Engr-Samson-Beloved/Goal-Line-Tech/GoalPost_Design_and_Code.docx

SMART GOAL-LINE DETECTION SYSTEM

Goal Post Unit — Design & Arduino Code

Chapter 3 Technical Reference | Hardware · Wiring · Firmware

# 1. Goal Post Unit — Design Overview

Each goal post unit is a completely self-contained system. It generates its own power from solar, detects ball crossings using two independent sensor rows, verifies the direction of crossing, and wirelessly notifies the referee. No cables connect it to any other unit.

## 1.1 System Block Diagram

┌─────────────────────────────────────────────────────────────────────┐

│ GOAL POST UNIT │

│ │

│ [SOLAR PANEL 50W] │

│ │ 12V DC │

│ ▼ │

│ [CHARGE CONTROLLER] ────────► [12V 12Ah BATTERY] │

│ │ │

│ ┌─────────────────────────────┤ │

│ │ 12V │ via BUCK │ via BUCK │

│ ▼ ▼ (5V) ▼ (3.3V) │

│ [8x E3F-10DN BEAM] [ESP32-CAM] [ESP32 CONTROLLER] │

│ Transmitters + ▲ │ │

│ Receivers │ UART │ GPIO reads │

│ └──────────┤ │

│ [8x TCRT5000] ──── GPIO ───────────────►│ │

│ (secondary row) │ │

│ │ SPI │

│ [MICROSD MODULE] ◄──────────────────────┤ │

│ │ ESP-NOW (wireless) │

└───────────────────────────────────────────┼─────────────────────────┘

│

▼

[REFEREE WRIST UNIT]

## 1.2 Complete Component List — Goal Post Unit

# | Component | Exact Name to Order | Qty | Role

1 | E3F-10DN Beam Sensor | E3F-10DN Infrared Through-Beam Photoelectric Sensor 10M NPN Opposite Type | 16 (8 pairs) | Primary detection — invisible curtain across goal line
2 | TCRT5000 | TCRT5000 Infrared Reflective Line Track Sensor Module | 8 | Secondary row — direction confirmation
3 | ESP32 Controller | ESP32 DevKit V1 30-pin | 1 | Main brain — all detection logic and wireless
4 | ESP32-CAM | ESP32-CAM AI-Thinker Module | 1 | Visual capture of every goal event
5 | OV2640 Fisheye Lens | OV2640 160 degree fisheye camera module | 1 | Widens camera view across goal area
6 | MicroSD Module | SPI MicroSD Card Adapter Module | 1 | Logs every event with timestamp
7 | Solar Panel | 50W 12V Monocrystalline Solar Panel | 1 | Primary power generation
8 | Charge Controller | PWM Solar Charge Controller 10A 12V | 1 | Manages battery charging safely
9 | Lead Acid Battery | 12V 12Ah Sealed Lead Acid Battery | 1 | Stores power for night and cloudy matches
10 | Buck Converter | LM2596 DC-DC Step Down Module | 2 | 12V→5V for camera, 12V→3.3V for controller
11 | IP65 Enclosure | IP65 Waterproof Junction Box Small | 3 | Weatherproofs electronics at each mount point
12 | 2N2222 Transistor | 2N2222 NPN Transistor | 4 | Protects GPIO pins from direct high current
13 | 1N4007 Diode | 1N4007 Rectifier Diode | 4 | Flyback protection for inductive loads
14 | Resistors | 330Ω resistor | 8 | Current limiting for sensor signal lines
15 | MicroSD Card | MicroSD Card 8GB or 16GB Class 10 | 1 | Storage medium for the SD module
16 | Jumper Wires | Male-to-female jumper wires 30cm | 2 packs | Component connections on breadboard/perfboard
17 | Perfboard | Universal PCB Prototype Board 10x15cm | 1 | Permanent mounting of controller connections

Buy all quantities twice — one complete set per goal post.

# 2. Sensor Design

## 2.1 Primary Sensor — E3F-10DN Through-Beam Array

The E3F-10DN is a through-beam sensor. The transmitter sits on one goal post and the receiver sits directly opposite on the other post. The transmitter fires a continuous invisible infrared beam at the receiver. When the ball passes through and blocks the beam, the receiver outputs a LOW signal to the ESP32.

## 2.2 Vertical Beam Placement

Eight beams are stacked vertically from ground level to the top of the goal. A standard football is 22cm in diameter. Beams are spaced 30cm apart. At that spacing it is physically impossible for the ball to pass between two beams.

LEFT POLE RIGHT POLE

│ │

[T8]═══════════════════ BEAM 8 ══════════════════════► [R8] 210cm — top corners

[T7]═══════════════════ BEAM 7 ══════════════════════► [R7] 180cm

[T6]═══════════════════ BEAM 6 ══════════════════════► [R6] 150cm

[T5]═══════════════════ BEAM 5 ══════════════════════► [R5] 120cm — chest height

[T4]═══════════════════ BEAM 4 ══════════════════════► [R4] 90cm

[T3]═══════════════════ BEAM 3 ══════════════════════► [R3] 60cm

[T2]═══════════════════ BEAM 2 ══════════════════════► [R2] 35cm — low drives

[T1]═══════════════════ BEAM 1 ══════════════════════► [R1] 10cm — ground rollers

│ │

══════════════════════ GOAL LINE (7.32m) ═══════════════════════

Transmitters [T1–T8] mount on the LEFT pole. Receivers [R1–R8] mount on the RIGHT pole. Both sets are fixed inside small IP65 enclosures with a clear lens window facing outward.

## 2.3 Secondary Sensor — TCRT5000 Direction Row

Eight TCRT5000 reflective sensors are mounted on a fabricated steel rod running the full 7.32m width of the goal, positioned 8cm inside the goal from the beam curtain, facing downward at the ground. When the ball passes over a sensor, its reflection is interrupted and the sensor outputs a LOW signal.

TOP VIEW — looking down from above:

PITCH SIDE

══ T1══ T2══ T3══ T4══ T5══ T6══ T7══ T8══ ← BEAM CURTAIN (goal line)

● ● ● ● ● ● ● ● ← TCRT5000 row (8cm inside)

S1 S2 S3 S4 S5 S6 S7 S8

GOAL NET SIDE

← 7.32m total width →

TCRT5000 sensors spaced every 91cm on welded rod facing downward

# 3. Full Wiring — Pin by Pin

## 3.1 E3F-10DN Beam Receivers → ESP32 Controller

Each receiver has 3 wires: Brown (+12V), Blue (GND), Black (signal output NPN). The signal wire connects to the ESP32 GPIO through a 330Ω resistor. When beam is clear the output is HIGH. When beam is broken the output is LOW.

Receiver | Wire Colour | Connects To | ESP32 GPIO
R1 (10cm) | Brown | 12V power rail | —
R1 (10cm) | Blue | GND | —
R1 (10cm) | Black (signal) | 330Ω → GPIO 13 | GPIO 13
R2 (35cm) | Black (signal) | 330Ω → GPIO 12 | GPIO 12
R3 (60cm) | Black (signal) | 330Ω → GPIO 14 | GPIO 14
R4 (90cm) | Black (signal) | 330Ω → GPIO 27 | GPIO 27
R5 (120cm) | Black (signal) | 330Ω → GPIO 26 | GPIO 26
R6 (150cm) | Black (signal) | 330Ω → GPIO 25 | GPIO 25
R7 (180cm) | Black (signal) | 330Ω → GPIO 33 | GPIO 33
R8 (210cm) | Black (signal) | 330Ω → GPIO 32 | GPIO 32

All 8 receivers share the same 12V and GND rails. Only the signal wire differs per receiver. All transmitters also share 12V and GND — they have no signal wire, just power.

## 3.2 TCRT5000 Sensors → ESP32 Controller

Each TCRT5000 has 4 pins: VCC, GND, D0 (digital), A0 (analog). Only VCC, GND, and D0 are used. D0 goes LOW when ball is detected above the sensor.

Sensor | VCC | GND | D0 → GPIO
S1 | 3.3V | GND | GPIO 23
S2 | 3.3V | GND | GPIO 22
S3 | 3.3V | GND | GPIO 21
S4 | 3.3V | GND | GPIO 19
S5 | 3.3V | GND | GPIO 18
S6 | 3.3V | GND | GPIO 5
S7 | 3.3V | GND | GPIO 17
S8 | 3.3V | GND | GPIO 16

## 3.3 ESP32-CAM → ESP32 Controller

The ESP32-CAM communicates via UART serial. It has its own ESP32 chip onboard. Use UART2 on the controller to leave UART0 free for USB debugging.

ESP32-CAM Pin | Controller Pin | Wire
TX (GPIO 1) | RX2 (GPIO 16 on controller — use a spare UART) | Yellow
RX (GPIO 3) | TX2 (GPIO 17 on controller) | Orange
GND | GND | Black
5V | 5V from buck converter output | Red
GPIO 0 | GND during flashing only — remove after | —

## 3.4 MicroSD Module → ESP32 Controller (SPI)

SD Module Pin | ESP32 GPIO | Notes
VCC | 3.3V | Power
GND | GND | Ground
CS | GPIO 4 | Chip Select
MOSI | GPIO 23 | Data to SD — share with SPI bus
CLK | GPIO 18 | Clock — share with SPI bus
MISO | GPIO 19 | Data from SD — share with SPI bus

Note: GPIO 23, 18, 19 are shared SPI pins. The SD module CS on GPIO 4 enables/disables it independently. If SPI conflicts arise, use a dedicated CS pin.

## 3.5 Power Wiring — Complete Rail Map

SOLAR PANEL (+) ─────► CHARGE CONTROLLER (Solar +)

SOLAR PANEL (−) ─────► CHARGE CONTROLLER (Solar −)

CHARGE CONTROLLER (Battery +) ──► BATTERY (+)

CHARGE CONTROLLER (Battery −) ──► BATTERY (−)

BATTERY (+) ──► FUSE (5A) ──► 12V RAIL

BATTERY (−) ──────────────────► GND RAIL

12V RAIL ──► E3F Transmitters (Brown wire)

12V RAIL ──► E3F Receivers (Brown wire)

GND RAIL ──► E3F Transmitters (Blue wire)

GND RAIL ──► E3F Receivers (Blue wire)

12V RAIL ──► BUCK CONVERTER 1 (IN+) ──► OUT+ = 5V

GND RAIL ──► BUCK CONVERTER 1 (IN−) ──► OUT− = GND

5V ──► ESP32-CAM (5V pin)

12V RAIL ──► BUCK CONVERTER 2 (IN+) ──► OUT+ = 3.3V

GND RAIL ──► BUCK CONVERTER 2 (IN−) ──► OUT− = GND

3.3V ──► ESP32 Controller (3.3V or VIN pin)

3.3V ──► All 8 TCRT5000 (VCC)

3.3V ──► MicroSD Module (VCC)

⚠ Critical Warning

Never connect 12V directly to any ESP32 pin. The ESP32 operates at 3.3V logic. Connecting 12V will permanently destroy the chip. The buck converters are not optional.

# 4. Detection Logic Flow

The ESP32 controller runs a continuous loop checking every sensor. The decision sequence is strict — both conditions must be met in the right order within the right time window.

┌─────────────────────────────────────────────────────────────────┐

│ ESP32 MAIN LOOP │

└─────────────────────────────────────────────────────────────────┘

│

▼

Any PRIMARY beam broken (LOW)?

│ │

YES NO ──► keep polling

│

▼

Start 50ms countdown timer

│

▼

Any SECONDARY TCRT5000 triggered within 50ms?

│ │

YES NO ──► REJECTED

│ log: NO_DIRECTION

▼

GOAL CONFIRMED

│

▼

Ask ESP32-CAM to capture frame (via UART)

│

▼

Send ESP-NOW wireless signal (Post ID + goal flag)

│

▼

Wait for ACK from wrist unit (200ms timeout)

│ │

ACK No ACK ──► retry up to 3 times

│

▼

Write event to SD card (timestamp + sensors + result)

│

▼

3 second cooldown ──► resume polling

# 5. Arduino Code — ESP32 Controller (Goal Post Brain)

This is the complete firmware for the ESP32 DevKit V1 that acts as the brain of each goal post unit. Flash using Arduino IDE. The only change between Goal Post A and Goal Post B is the POST_ID variable on line 1.

## 5.1 Required Libraries

Install these in Arduino IDE via Tools → Manage Libraries:

- ESP-NOW — built into ESP32 Arduino core, no install needed
- WiFi — built into ESP32 Arduino core, no install needed
- SD — built into Arduino, no install needed
- SPI — built into Arduino, no install needed

## 5.2 Full Goal Post Controller Code

// ═══════════════════════════════════════════════════════════════════

// SMART GOAL-LINE DETECTION SYSTEM

// Goal Post Controller Firmware — ESP32 DevKit V1

// Change POST_ID below: "A" for Goal Post A, "B" for Goal Post B

// ═══════════════════════════════════════════════════════════════════

#include <esp_now.h>

#include <WiFi.h>

#include <SD.h>

#include <SPI.h>

// ── CONFIGURATION ───────────────────────────────────────────────────

const String POST_ID = "A"; // "A" or "B"

// Wrist unit MAC address — replace with your ESP32-C3 MAC address

// Find it by uploading a blank sketch and reading Serial Monitor

uint8_t WRIST_MAC[] = {0xFF, 0xFF, 0xFF, 0xFF, 0xFF, 0xFF};

// ── PRIMARY BEAM RECEIVER PINS (E3F-10DN signal wires) ──────────────

const int PRIMARY[8] = {13, 12, 14, 27, 26, 25, 33, 32};

// R1 R2 R3 R4 R5 R6 R7 R8

// 10cm 35cm 60cm 90cm 120cm 150cm 180cm 210cm

// ── SECONDARY TCRT5000 PINS ─────────────────────────────────────────

const int SECONDARY[8] = {23, 22, 21, 19, 18, 5, 17, 16};

// S1 S2 S3 S4 S5 S6 S7 S8

// ── SD CARD ─────────────────────────────────────────────────────────

const int SD_CS = 4;

// ── STATE VARIABLES ─────────────────────────────────────────────────

bool primaryTriggered = false;

bool ackReceived = false;

unsigned long primaryTime = 0;

const unsigned long DIRECTION_WINDOW = 50; // milliseconds

const unsigned long ACK_TIMEOUT = 200; // milliseconds

const int MAX_RETRIES = 3;

const unsigned long COOLDOWN = 3000; // milliseconds

// ── MESSAGE STRUCTURE ────────────────────────────────────────────────

typedef struct {

char postID[2];

bool isGoal;

unsigned long timestamp;

} GoalMessage;

// ═══════════════════════════════════════════════════════════════════

// LOGGING

// ═══════════════════════════════════════════════════════════════════

void logEvent(String result, int beamTriggered, int tcrtTriggered) {

if (!SD.begin(SD_CS)) return;

File f = SD.open("/goallog.txt", FILE_APPEND);

if (f) {

f.print("TIME:");

f.print(millis());

f.print(" POST:");

f.print(POST_ID);

f.print(" BEAM:");

f.print(beamTriggered);

f.print(" TCRT:");

f.print(tcrtTriggered);

f.print(" RESULT:");

f.println(result);

f.close();

}

}

// ═══════════════════════════════════════════════════════════════════

// ESP-NOW — ACK RECEIVED FROM WRIST UNIT

// ═══════════════════════════════════════════════════════════════════

void onDataRecv(const uint8_t *mac, const uint8_t *data, int len) {

ackReceived = true;

Serial.println("ACK received from wrist unit.");

}

// ═══════════════════════════════════════════════════════════════════

// SEND GOAL SIGNAL TO WRIST UNIT (with retry)

// ═══════════════════════════════════════════════════════════════════

void sendGoalSignal(int beamNum, int tcrtNum) {

GoalMessage msg;

POST_ID.toCharArray(msg.postID, 2);

msg.isGoal = true;

msg.timestamp = millis();

ackReceived = false;

for (int attempt = 1; attempt <= MAX_RETRIES; attempt++) {

Serial.print("Sending goal signal — attempt ");

Serial.println(attempt);

esp_now_send(WRIST_MAC, (uint8_t*)&msg, sizeof(msg));

unsigned long sent = millis();

while (!ackReceived && (millis() - sent) < ACK_TIMEOUT) {

delay(5);

}

if (ackReceived) {

Serial.println("GOAL confirmed and acknowledged.");

logEvent("GOAL_CONFIRMED", beamNum, tcrtNum);

return;

}

}

Serial.println("WARNING: No ACK received after 3 attempts.");

logEvent("GOAL_NO_ACK", beamNum, tcrtNum);

}

// ═══════════════════════════════════════════════════════════════════

// CHECK PRIMARY BEAMS — returns index of triggered beam, -1 if none

// ═══════════════════════════════════════════════════════════════════

int checkPrimary() {

for (int i = 0; i < 8; i++) {

if (digitalRead(PRIMARY[i]) == LOW) {

return i; // return which beam was broken

}

}

return -1;

}

// ═══════════════════════════════════════════════════════════════════

// CHECK SECONDARY TCRT — returns index of triggered sensor, -1 if none

// ═══════════════════════════════════════════════════════════════════

int checkSecondary() {

for (int i = 0; i < 8; i++) {

if (digitalRead(SECONDARY[i]) == LOW) {

return i;

}

}

return -1;

}

// ═══════════════════════════════════════════════════════════════════

// ASK ESP32-CAM TO CAPTURE A FRAME

// ═══════════════════════════════════════════════════════════════════

void requestCameraCapture() {

Serial2.println("CAPTURE"); // ESP32-CAM listens on its UART

delay(100); // give camera time to respond

}

// ═══════════════════════════════════════════════════════════════════

// SETUP

// ═══════════════════════════════════════════════════════════════════

void setup() {

Serial.begin(115200);

Serial2.begin(115200, SERIAL_8N1, 16, 17); // UART2 for ESP32-CAM

// Configure all sensor pins as inputs with pull-up resistors

for (int i = 0; i < 8; i++) {

pinMode(PRIMARY[i], INPUT_PULLUP);

pinMode(SECONDARY[i], INPUT_PULLUP);

}

// Initialise SD card

if (SD.begin(SD_CS)) {

Serial.println("SD card ready.");

} else {

Serial.println("SD card not found — logging disabled.");

}

// Initialise ESP-NOW

WiFi.mode(WIFI_STA);

if (esp_now_init() != ESP_OK) {

Serial.println("ESP-NOW init failed.");

return;

}

esp_now_register_recv_cb(onDataRecv);

// Register wrist unit as ESP-NOW peer

esp_now_peer_info_t peer = {};

memcpy(peer.peer_addr, WRIST_MAC, 6);

peer.channel = 0;

peer.encrypt = false;

esp_now_add_peer(&peer);

Serial.print("Goal Post ");

Serial.print(POST_ID);

Serial.println(" ready and monitoring.");

}

// ═══════════════════════════════════════════════════════════════════

// MAIN LOOP

// ═══════════════════════════════════════════════════════════════════

void loop() {

// ── STEP 1: Check primary beam sensors ──────────────────────────

int beamIndex = checkPrimary();

if (beamIndex >= 0 && !primaryTriggered) {

// A beam was just broken for the first time

primaryTriggered = true;

primaryTime = millis();

Serial.print("Primary beam broken: R");

Serial.println(beamIndex + 1);

}

// ── STEP 2: If primary triggered, watch for secondary ────────────

if (primaryTriggered) {

unsigned long elapsed = millis() - primaryTime;

if (elapsed <= DIRECTION_WINDOW) {

int tcrtIndex = checkSecondary();

if (tcrtIndex >= 0) {

// Secondary fired within the 50ms window — GOAL

Serial.println("Direction confirmed: INWARD. GOAL!");

requestCameraCapture();

sendGoalSignal(beamIndex, tcrtIndex);

primaryTriggered = false;

delay(COOLDOWN); // prevent double-counting

}

} else {

// 50ms window expired without secondary — REJECT

Serial.println("Direction window expired. Event rejected.");

logEvent("REJECTED_NO_DIRECTION", beamIndex, -1);

primaryTriggered = false;

}

}

delay(1); // tiny delay to prevent watchdog reset

}

# 6. Arduino Code — ESP32-CAM

The ESP32-CAM runs its own separate firmware. It sits idle waiting for the controller to send a CAPTURE command over UART. When it receives the command it saves a JPEG image to the SD card with a timestamp filename.

## 6.1 Required Libraries

- esp_camera — built into ESP32 Arduino core for AI-Thinker board
- FS, SD_MMC — built in for file system and SD access on CAM board

## 6.2 Full ESP32-CAM Code

// ═══════════════════════════════════════════════════════════════════

// SMART GOAL-LINE DETECTION SYSTEM

// ESP32-CAM Firmware — AI-Thinker Board

// Listens on UART for CAPTURE command, saves JPEG to SD

// ═══════════════════════════════════════════════════════════════════

#include "esp_camera.h"

#include "FS.h"

#include "SD_MMC.h"

// AI-Thinker ESP32-CAM pin definition

#define PWDN_GPIO_NUM 32

#define RESET_GPIO_NUM -1

#define XCLK_GPIO_NUM 0

#define SIOD_GPIO_NUM 26

#define SIOC_GPIO_NUM 27

#define Y9_GPIO_NUM 35

#define Y8_GPIO_NUM 34

#define Y7_GPIO_NUM 39

#define Y6_GPIO_NUM 36

#define Y5_GPIO_NUM 21

#define Y4_GPIO_NUM 19

#define Y3_GPIO_NUM 18

#define Y2_GPIO_NUM 5

#define VSYNC_GPIO_NUM 25

#define HREF_GPIO_NUM 23

#define PCLK_GPIO_NUM 22

int imageCount = 0;

void initCamera() {

camera_config_t config;

config.ledc_channel = LEDC_CHANNEL_0;

config.ledc_timer = LEDC_TIMER_0;

config.pin_d0 = Y2_GPIO_NUM;

config.pin_d1 = Y3_GPIO_NUM;

config.pin_d2 = Y4_GPIO_NUM;

config.pin_d3 = Y5_GPIO_NUM;

config.pin_d4 = Y6_GPIO_NUM;

config.pin_d5 = Y7_GPIO_NUM;

config.pin_d6 = Y8_GPIO_NUM;

config.pin_d7 = Y9_GPIO_NUM;

config.pin_xclk = XCLK_GPIO_NUM;

config.pin_pclk = PCLK_GPIO_NUM;

config.pin_vsync = VSYNC_GPIO_NUM;

config.pin_href = HREF_GPIO_NUM;

config.pin_sscb_sda = SIOD_GPIO_NUM;

config.pin_sscb_scl = SIOC_GPIO_NUM;

config.pin_pwdn = PWDN_GPIO_NUM;

config.pin_reset = RESET_GPIO_NUM;

config.xclk_freq_hz = 20000000;

config.pixel_format = PIXFORMAT_JPEG;

config.frame_size = FRAMESIZE_VGA; // 640x480

config.jpeg_quality = 12;

config.fb_count = 1;

esp_camera_init(&config);

}

void captureAndSave() {

camera_fb_t *fb = esp_camera_fb_get();

if (!fb) {

Serial.println("Camera capture failed.");

return;

}

String path = "/goal_" + String(millis()) + ".jpg";

fs::FS &fs = SD_MMC;

File file = fs.open(path.c_str(), FILE_WRITE);

if (file) {

file.write(fb->buf, fb->len);

file.close();

Serial.print("Image saved: ");

Serial.println(path);

}

esp_camera_fb_return(fb);

}

void setup() {

Serial.begin(115200); // UART0 — debug

// UART1 receives commands from ESP32 Controller

// Uses default RX=GPIO3, TX=GPIO1 on AI-Thinker

initCamera();

SD_MMC.begin();

Serial.println("ESP32-CAM ready. Waiting for CAPTURE command.");

}

void loop() {

if (Serial.available()) {

String cmd = Serial.readStringUntil("\n");

cmd.trim();

if (cmd == "CAPTURE") {

Serial.println("Capturing...");

captureAndSave();

}

}

}

# 7. How to Flash the Code

## 7.1 Setting Up Arduino IDE

1. Download Arduino IDE from arduino.cc
2. Open Arduino IDE → File → Preferences
3. In "Additional Boards Manager URLs" paste: https://raw.githubusercontent.com/espressif/arduino-esp32/gh-pages/package_esp32_index.json
4. Go to Tools → Board → Boards Manager → search "esp32" → install "ESP32 by Espressif"
5. Install libraries: Tools → Manage Libraries → search and install "Adafruit SSD1306" and "Adafruit GFX Library"

## 7.2 Flashing the ESP32 Controller

6. Connect ESP32 DevKit V1 to laptop via USB cable
7. Tools → Board → ESP32 Arduino → ESP32 Dev Module
8. Tools → Port → select the COM port that appears
9. Tools → Upload Speed → 115200
10. Paste the Goal Post Controller code into IDE
11. Change POST_ID to "A" or "B" as required
12. Replace WRIST_MAC with the actual MAC address of your ESP32-C3
13. Click Upload (arrow button)
14. Open Serial Monitor (Tools → Serial Monitor) at 115200 baud to verify "Goal Post A ready"

## 7.3 Flashing the ESP32-CAM

15. Connect ESP32-CAM to a USB-to-TTL adapter (not directly to USB)
16. Wire: adapter TX → CAM GPIO 3, adapter RX → CAM GPIO 1, adapter GND → CAM GND, adapter 5V → CAM 5V
17. Bridge GPIO 0 to GND on the CAM board to enter flash mode
18. Tools → Board → AI Thinker ESP32-CAM
19. Click Upload
20. Remove the GPIO 0 to GND bridge after flashing completes
21. Power cycle the board — it will boot and print "ESP32-CAM ready"

Finding Your ESP32-C3 MAC Address

Upload this to your ESP32-C3, then open Serial Monitor:

#include <WiFi.h>

void setup() {

Serial.begin(115200);

WiFi.mode(WIFI_STA);

Serial.println(WiFi.macAddress());

}

void loop() {}

Copy the address shown (format: XX:XX:XX:XX:XX:XX) and replace WRIST_MAC in the goal post code.

# 8. Testing the Goal Post Unit

Test | How To Do It | Expected Result
Beam alignment | Power on, open Serial Monitor — it should not print anything unless a beam is broken | Silence = beams are aligned and working
Single beam trigger | Block one receiver with your hand | Serial prints "Primary beam broken: R[x]"
Direction confirm (goal) | Block a beam then immediately pass hand over a TCRT5000 sensor within 50ms | Serial prints "GOAL!" — wrist unit buzzes
Direction reject (clearance) | Trigger a TCRT5000 first, then block a beam | Serial prints "REJECTED_NO_DIRECTION"
SD logging | Trigger a goal, remove SD card, read in a PC | goallog.txt contains the event with timestamp
Wireless range | Stand 50m from post and trigger a goal | Wrist unit receives and buzzes within 500ms
Power endurance | Run for 120 minutes without charging | System stays on. No resets.
Rain test | Spray water at the enclosure | Electronics stay dry. System keeps working.

Smart Goal-Line Detection System | Goal Post Design & Firmware Reference
