Engr-Samson-Beloved/Goal-Line-Tech/(commit log)

2026-09-21 feat: add PowerShell scripts for ESP32 board connectivity checks, test execution, and known boards registry
2026-09-22 feat: add ESP-NOW firmware for wrist unit and goal post controller with board configurations
2026-10-18 feat: integrate production goal-line devices
2026-10-18 fix: reconnect active camera stream
2026-10-19 fix: report line sensors in real time
